srgemb/KeyPad/Doc/keypad_code.pdf

A | B | C | D | E
F1 | F2 | | ESC |
F6 | F7 | PGUP | \ | SPACE
0x02 - 1 | 0x20 - 1 | 0x01 - 1 | 0x40 - 1 | 0x80 - 1
F | G | H | I | J
F3 | | | | *
F8 | HOME | PGDN | END | /
0x02 - 0 | 0x20 - 0 | 0x01 - 0 | 0x40 - 0 | 0x80 - 0
K | L | M | N | O
F4 | | | | +
F9 | | | | -
0x02 - 7 | 0x20 - 7 | 0x01 - 7 | 0x40 - 7 | 0x80 - 7
P | Q | R | S | T
F5 | | | | .
F10 | | | | :
0x02 - 2 | 0x20 - 2 | 0x01 - 2 | 0x40 - 2 | 0x80 - 2
| U | V | W | X
| | | | ENTER
0x10 - 4 | 0x20 - 6 | 0x01 - 6 | 0x40 - 6 | 0x80 - 6

Y Z
| ALPHA | 0 | ,
| | INS | DEL
0x02 - 3 | 0x10 - 5 | 0x20 - 3 | 0x01 - 3 | 0x04 - 3

## Скан коды (0xNN) и индексы сканирования (0 ... 7)

CTRL

SHIFT | ALT

7

4 | 5 | 6

8 9

1 | 2 | 3
