srgemb/KeyPad/Doc/pcb3d_bottom.png

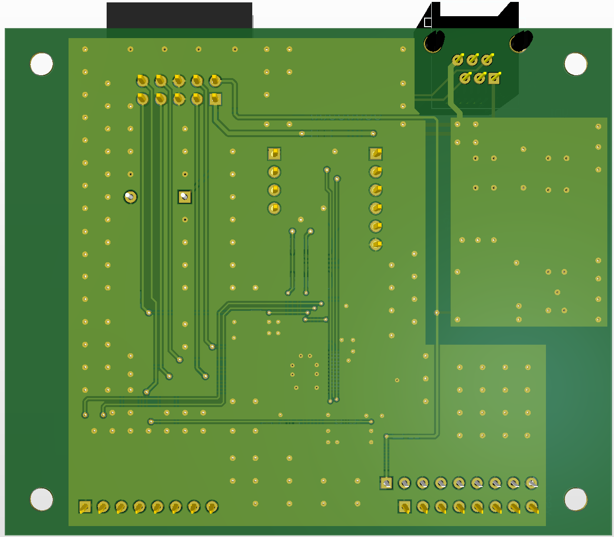
Doc/pcb3d_bottom.png
