srgemb/KeyPad/Doc/SKT-3.png

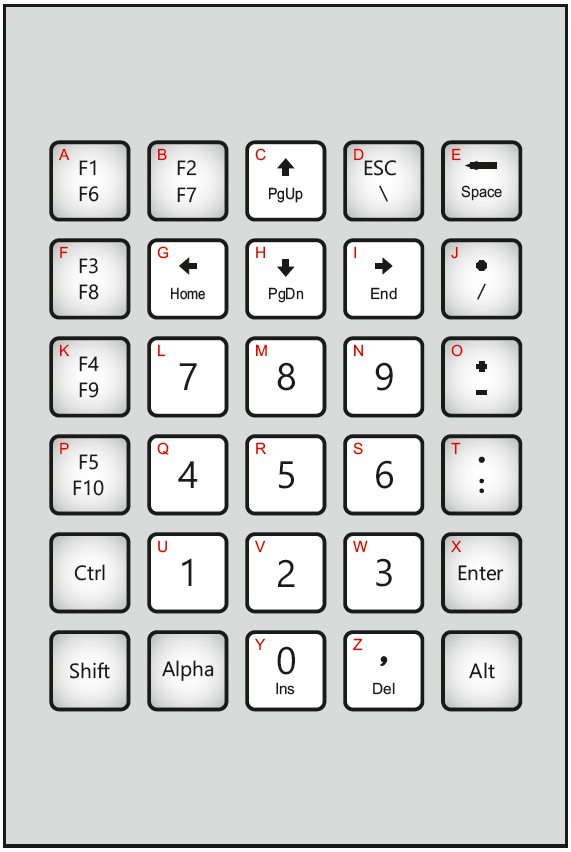
Doc/SKT-3.png
