srgemb/KeyPad/Doc/KeyPad_pcd3d.pdf

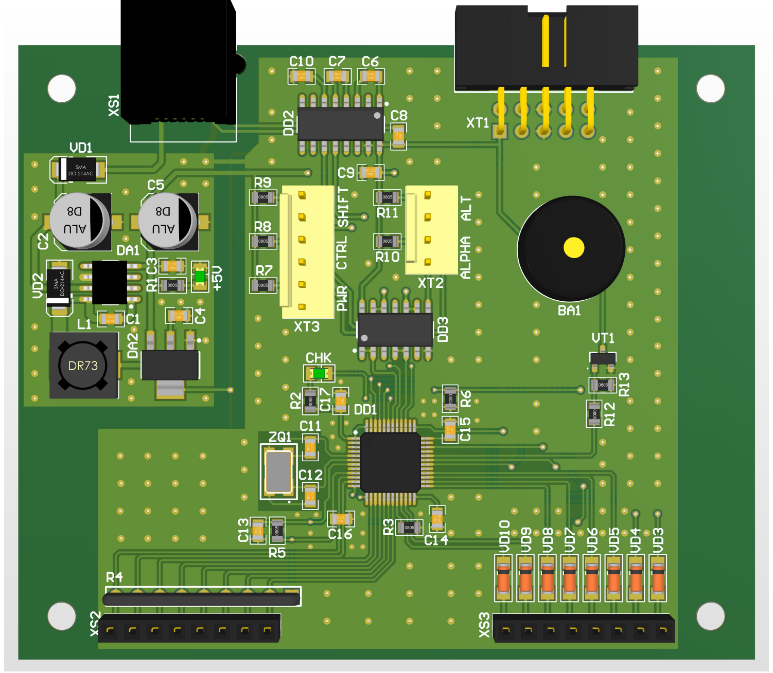
[picture p9: page 1]

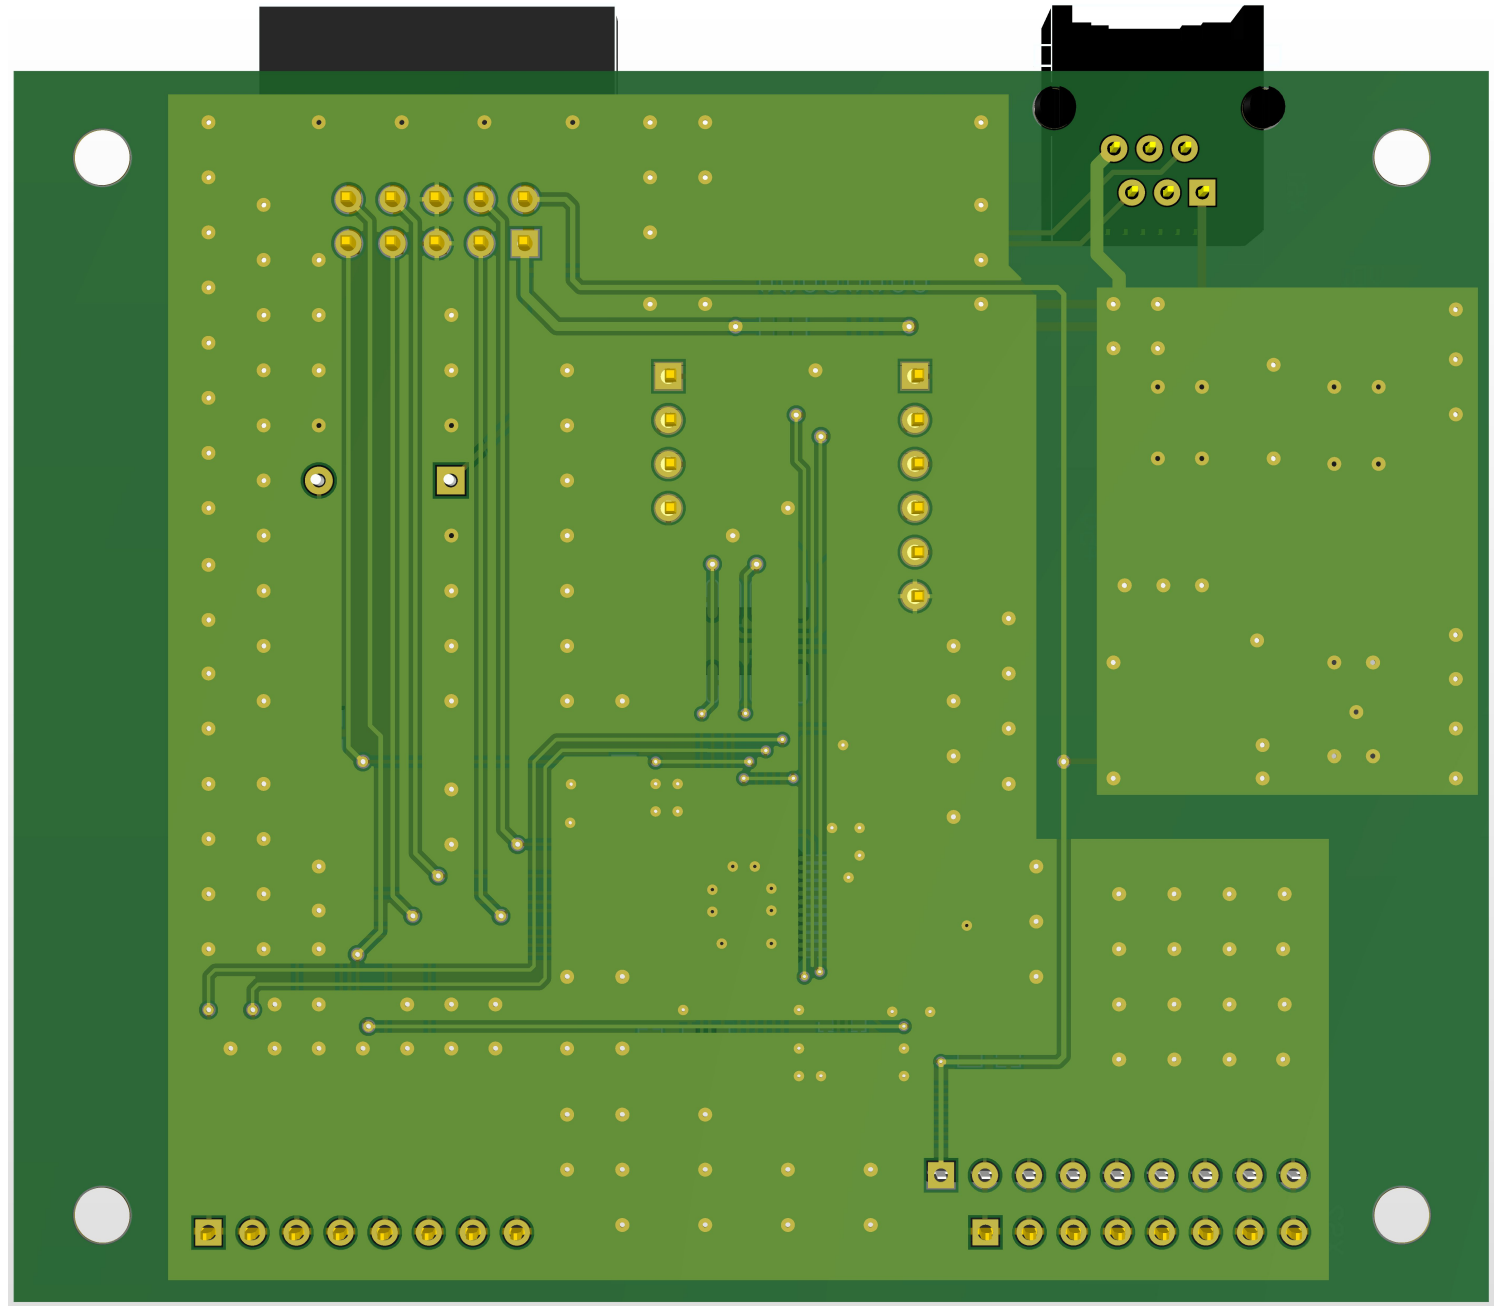
[picture p10: page 2]
