srgemb/KeyPad/Doc/KeyPad_sch.pdf

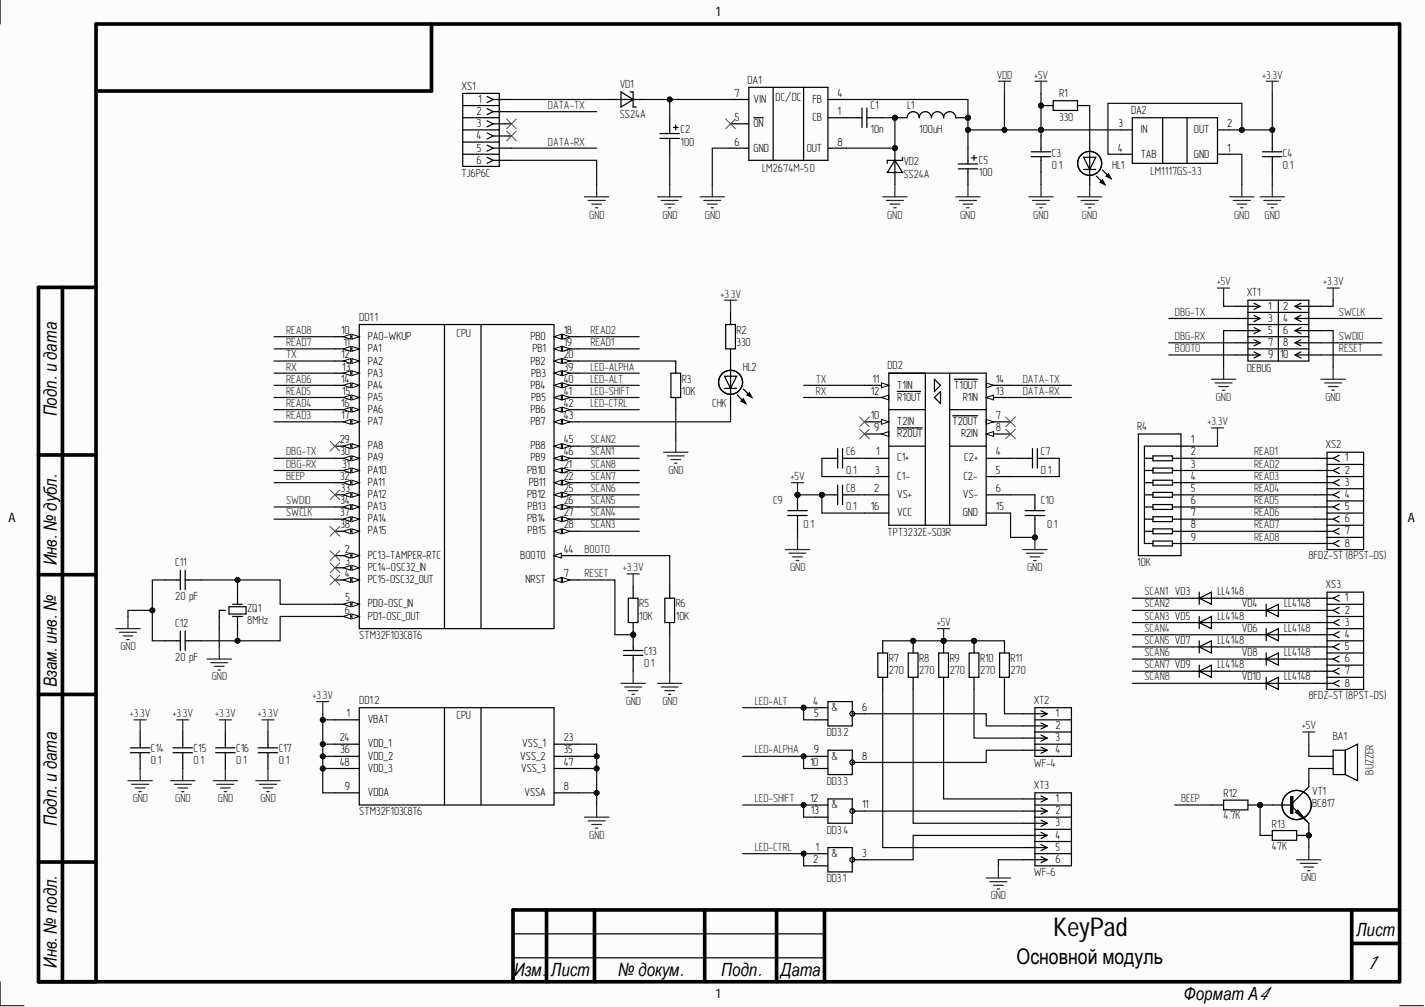
[picture p11: page 1]

Инв. № подл. Инв. № дубл. Подп. и дата Взам. инв. №
