srgemb/KeyPad/FirmWare/Source/main.h

#ifndef __MAIN_H
#define __MAIN_H

//*************************************************************************************************
// Функции управления
//*************************************************************************************************
void WdtReload( void );

#endif 
