srgemb/KeyPad/FirmWare/Source/key.h

#ifndef __KEY_H
#define __KEY_H

#include <stdint.h>
#include <stdbool.h>

//*************************************************************************************************
// Прототипы функций
//*************************************************************************************************
uint8_t GetKey( uint8_t alt_key, uint8_t index, uint8_t value );

#endif
