srgemb/KeyPad/FirmWare/Source/key_def.h

#ifndef __KEY_DEF_H
#define __KEY_DEF_H

#include <stdint.h>
#include <stdbool.h>

#define KEY_0           0x30
#define KEY_1           0x31
#define KEY_2           0x32
#define KEY_3           0x33
#define KEY_4           0x34
#define KEY_5           0x35
#define KEY_6           0x36
#define KEY_7           0x37
#define KEY_8           0x38
#define KEY_9           0x39

#define KEY_UP_A        0x41
#define KEY_UP_B        0x42
#define KEY_UP_C        0x43
#define KEY_UP_D        0x44
#define KEY_UP_E        0x45
#define KEY_UP_F        0x46
#define KEY_UP_G        0x47
#define KEY_UP_H        0x48
#define KEY_UP_I        0x49
#define KEY_UP_J        0x4A
#define KEY_UP_K        0x4B
#define KEY_UP_L        0x4C
#define KEY_UP_M        0x4D
#define KEY_UP_N        0x4E
#define KEY_UP_O        0x4F
#define KEY_UP_P        0x50
#define KEY_UP_Q        0x51
#define KEY_UP_R        0x52
#define KEY_UP_S        0x53
#define KEY_UP_T        0x54
#define KEY_UP_U        0x55
#define KEY_UP_V        0x56
#define KEY_UP_W        0x57
#define KEY_UP_X        0x58
#define KEY_UP_Y        0x59
#define KEY_UP_Z        0x5A

#define KEY_LO_A        0x61
#define KEY_LO_B        0x62
#define KEY_LO_C        0x63
#define KEY_LO_D        0x64
#define KEY_LO_E        0x65
#define KEY_LO_F        0x66
#define KEY_LO_G        0x67
#define KEY_LO_H        0x68
#define KEY_LO_I        0x69
#define KEY_LO_J        0x6A
#define KEY_LO_K        0x6B
#define KEY_LO_L        0x6C
#define KEY_LO_M        0x6D
#define KEY_LO_N        0x6E
#define KEY_LO_O        0x6F
#define KEY_LO_P        0x70
#define KEY_LO_Q        0x71
#define KEY_LO_R        0x72
#define KEY_LO_S        0x73
#define KEY_LO_T        0x74
#define KEY_LO_U        0x75
#define KEY_LO_V        0x76
#define KEY_LO_W        0x77
#define KEY_LO_X        0x78
#define KEY_LO_Y        0x79
#define KEY_LO_Z        0x7A

#define KEY_F1          0x10    //
#define KEY_F2          0x11    //
#define KEY_F3          0x12
#define KEY_F4          0x13
#define KEY_F5          0x14
#define KEY_F6          0x15
#define KEY_F7          0x16
#define KEY_F8          0x17
#define KEY_F9          0x18
#define KEY_F10         0x19

#define KEY_SPACE       0x20
#define KEY_ESC         0x1B
#define KEY_DOT         0x2E    //.
#define KEY_COLON       0x3A    //:
#define KEY_COMMA       0x2C    //,
#define KEY_MULTPL      0x2A    //*
#define KEY_MINUS       0x2D    //-
#define KEY_PLUS        0x2B    //+
#define KEY_FSLASH      0x2F    // "/"
#define KEY_BSLASH      0x5C    // "\"
#define KEY_BS          0x08    //<-
#define KEY_INS         0x05
#define KEY_DEL         0x06
#define KEY_CR          0x0D
#define KEY_LF          0x0A

#define KEY_LEFT        0x01
#define KEY_RIGHT       0x02
#define KEY_UP          0x03
#define KEY_DOWN        0x04

#define KEY_HOME        0x1C
#define KEY_END         0x1D
#define KEY_PGUP        0x1E
#define KEY_PGDN        0x1F

#endif
