srgemb/KeyPad/FirmWare/Source/crc16.h

#ifndef __CRC16_H
#define __CRC16_H

#include <stdio.h>
#include <stdint.h>

//*************************************************************************************************
// Функции управления
//*************************************************************************************************
uint16_t CalcCRC16( uint8_t *buf, uint16_t len );

#endif
