srgemb/KeyPad/(commit log)

2025-04-07 Начальная версия.
2025-05-04 Исправлена настройка частоты APB1.
    [main.c, verdata.h]
2025-05-05 Изменен режим JTAG-SWD на SWD.
2025-07-31 1. Добавлена отдельная команда сохранения макросов в FLASH памяти. 2. Доработан режим загрузки макросов по UART2.
